Therainxin/ph-control-vfa-alk-system/lite/Lite_参数与烧录手册.docx

Lite 参数与烧录手册

Lite 固件文件：

lite/Arduino UNO例程/xy_orp_arduino/xy_orp_arduino.ino

本手册与上面的一个 .ino 是 Lite 的两项正式交付。目录中的接线图和结果图片是用户原有素材，请保留。

这两个 Lite 交付文件均使用 UTF-8（无 BOM）编码，可直接用 Arduino IDE 2.x 打开。

接线

Lite 与完整版接线完全相同：

功能 | ArduinoUno引脚
ORP 模块软件串口 | D2/D3
启动按钮 | D4
碱泵 | D13
酸泵 | D12
水泵 | D11
OLED I2C | A4/A5

继电器按现有固件使用高电平启动。上电初始化和配置错误状态下，三路泵均保持关闭。

配置位置

用 Arduino IDE 打开 Lite .ino，只编辑文件最顶部：

Lite 用户配置区：只修改本区参数

仓库中的参数只是编译示例，不是设备实测值。完成泵流量与 pH 标定、填写真实参数后，必须把：

const bool LITE_CONFIGURED = false;

改为：

const bool LITE_CONFIGURED = true;

否则固件会显示并输出 CONFIG ERROR，禁止三路泵、测量流程和 D4 启动。

参数与单位

参数 | 含义 | 单位
CFG_BASE_PUMP_FLOW_ML_S | 碱泵流速 | mL/s
CFG_ACID_PUMP_FLOW_ML_S | 酸泵流速 | mL/s
CFG_WATER_PUMP_FLOW_ML_S | 水泵流速 | mL/s
CFG_PH_SLOPE_PH_PER_MV | pH 线性换算斜率 | pH/mV
CFG_PH_INTERCEPT_PH | pH 线性换算截距 | pH
CFG_ACID_CONCENTRATION_MOL_L | 酸浓度 | mol/L
CFG_SAMPLE_VOLUME_ML | 样品体积 | mL
CFG_TARGET_PH | 普通滴定目标 | pH
CFG_TRIGGER_PH | 普通流程触发值 | pH
CFG_TOLERANCE_PH | 目标容差 | pH
CFG_MIX_SECONDS | 每次滴加后的混合时间 | s
CFG_TITRATION_DIRECTION | 滴定方向，0 加碱、1 加酸 | 无量纲
CFG_KV | VFA 最终结果校正系数 | 无量纲
CFG_KA | ALK 最终结果校正系数 | 无量纲

顶部还提供 VFA/ALK 流程参数：起始 pH 门槛、两阶段目标 pH、稳定性范围、观察时间、总超时和空白修正。没有明确工艺依据时不要修改。

CFG_KV 和 CFG_KA 默认均为 1.0，此时最终结果等于原公式结果。修改后，OLED 与串口输出的 VFA/ALK 都会应用对应系数。

参数来源

Lite 不提供上位机参数下发、串口写参数、泵流量标定、预充液或 PC 启动命令。

- 泵流速必须在固件外部实测：实际体积 ÷ 实际运行时间。
- pH slope/intercept 必须来自本机电极和模块的标准缓冲液标定。
- 酸浓度和样品体积必须按实际实验条件填写。

不要把仓库示例值直接用于真实加药或样品测量。

Arduino IDE 验证与上传

1. 打开 lite/Arduino UNO例程/xy_orp_arduino/xy_orp_arduino.ino。

2. 填写真实参数，并将 LITE_CONFIGURED 改为 true。

3. 选择开发板 Arduino Uno。

4. 选择设备对应串口。

5. 点击“验证”，确认编译成功。

6. 点击“上传”，等待烧录完成后重新上电。

非法、非有限或越界参数不会启动流程。OLED 显示 CONFIG ERROR，串口给出错误字段，三路泵保持关闭。

脱机操作

有效配置上电后无需连接 PC：

1. OLED 显示待机页。

2. 确认使用未经普通 pH 调节的原始样品。

3. 空闲时按一次 D4，直接启动完整 VFA/ALK 两阶段流程。

4. 观察 PH0、第一阶段 V1、第二阶段 V2。

5. 完成页显示 PH0/V1/V2/VFA/ALK。

测量过程中出现错误或超时会立即停泵。完成页再次按 D4 返回待机。

Lite 参数与烧录手册
