Therainxin/ph-control-vfa-alk-system/泵流量标定操作卡.md

# 泵流量标定操作卡

## 适用范围

适用于当前 V1 版本上位机 + 支持 FCAL 协议的 MCU 固件。

## 开始前检查

1. Arduino 已连接，上位机状态正常。
2. 当前没有正在运行的 VFA、自动滴定或手动泵动作。
3. 量筒已放好，出口液体不会流回样品瓶。
4. 明确本次排液不计入业务累计体积。

## 快速步骤

1. 在主界面“泵流速 (ml/s)”区域点击“流量标定”。
2. 选择泵：
   - `B - 碱泵`
   - `A - 酸泵`
   - `W - 水泵`
3. 填写液体名称、管规格、泵/通道、温度、备注。
4. 如需排气，点击“开始预充”；预充运行中同一个按钮会变成“停止预充”，再次点击即可发送 `FCAL STOP`，旁边“立即停止”也始终可用。
5. 选择正式标定时长：
   - 常用：5 / 10 / 30 / 60 秒
   - 自定义：3–120 秒
6. 点击“开始标定”，确认安全提示。
7. 运行结束后，把量筒体积填入“量筒体积 (ml)”。
8. 点击“保存为下一点”；保存后窗口应显示当前进度 `1/3`、`2/3` 或 `3/3`。
9. 只要刚结束的这次运行已经保存为候选点，就可以继续同一泵、同一配置的下一次正式标定；只有“待回填运行”还没保存/丢弃时，下一次预充或标定才会被阻止。
10. 达到 `3/3` 后停止继续采点，改为“保存记录”、“保存并应用”或“清空本次点位”。
11. 点击：
    - “保存记录”：只存历史
    - “保存并应用”：存历史并尝试下发 MCU
12. 同一组 1 / 2 / 3 个点可以故意使用不同的标定时长，例如先用 10 秒、后用 30 秒。

## 判定规则

- 用户提前停止：
  - 实际时间 `>= 3s`：该点有效，标记为提前停止
  - 实际时间 `< 3s`：该点作废
- D4 按键紧急停止：该点无效
- 错误中止 / 断连：该点无效
- 单点相对各点流速的算术平均值偏离 `> 10%`：给出警告，但可继续保存
- 最终流速超出 `0.001–100 ml/s`：需要二次确认

## 结果解释

- 单点流速 = 该点体积 / 该点 MCU 实际时间
- 最终流速 = 总体积 / 总实际时间
- 窗口显示 4 位小数
- 下发 MCU 与持久化保存 6 位小数

## 常见提示

- `FCAL: 未探测到支持`
  - 固件太旧，必须升级 MCU，不能用 PC 本地计时替代
- `ERR:FCAL BUSY`
  - 仍有其他流程占用，先停掉自动滴定 / VFA / 其他泵
- `不能开始下一次标定`
  - 先区分当前是“待回填运行”还是“已保存候选点”
  - 待回填运行：必须先保存体积或明确丢弃
  - 已保存候选点：同一会话可继续到第 2 / 3 点；若已到 `3/3`，需先保存记录、保存并应用或清空本次点位
- `流速未生效`
  - MCU 没有接受新的 `FB/FA/FW`，历史会保留，但当前流速不会切换
  - 若 ACK 超时、ACK 数值不匹配或串口中断，界面会恢复旧生效值，不会把失败草稿写入配置

## 现场安全

- 全程佩戴护目镜、耐化学品手套、实验服。
- 软管出口必须固定在量筒或接液容器内，容器下方必须放接液盘。
- 酸、碱、水分别使用清洁容器，避免交叉污染。
- 标定液和废液按实验室规定处置，禁止直接回倒样品或随意排放。

## 结束后确认

1. 主界面流速来源已切换为：
   - `来源: 标定 <记录ID>`，或
   - `来源: 手动`
2. 串口日志中已经看到对应 ACK。
3. 如果只是留档，不要求来源切换。
4. 若关闭窗口、断开串口或退出程序时仍在运行，必须等收到 MCU 终态后再关闭/断开；若超时未确认停泵，程序会取消退出/断开并要求现场检查。
